radio-satellites/OS-41_PCB/README.md

# OS-41 PCB Tracker
