radio-satellites/OS-41_PCB/ANT_1575AT_JOT.step

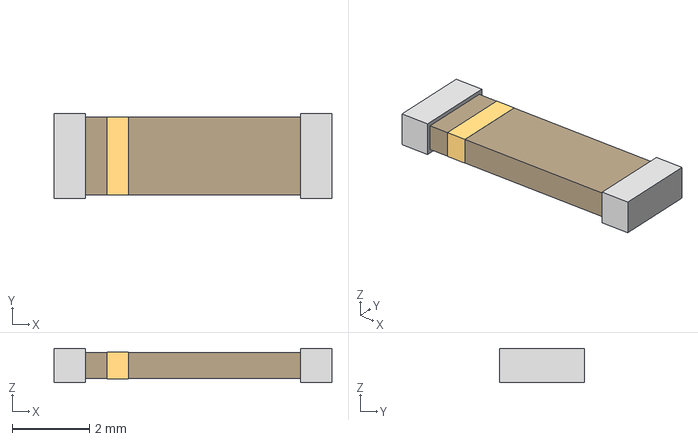
[picture p1: CAD file, 2025-06-10]
ANT_1575AT_JOT.step
7.19 x 2.21 x 0.889 mm
