radio-satellites/OS-41_PCB/Si4432.STEP

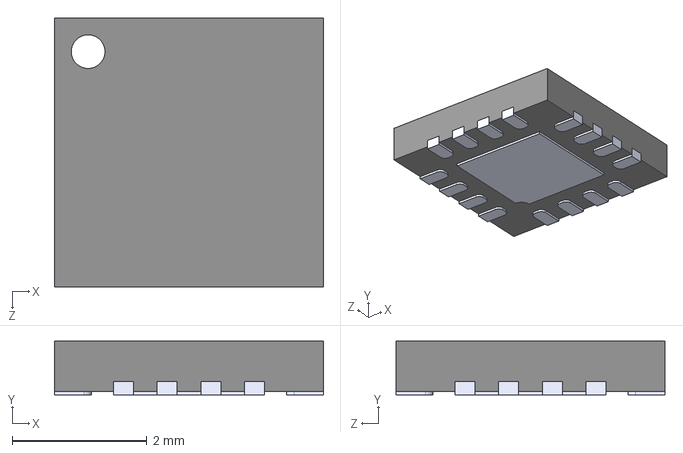
[picture p2: CAD file, 2025-05-10]
Si4432.STEP
4.00 x 0.8 x 4.00 mm
