radio-satellites/OS-41_PCB/STM32.STEP

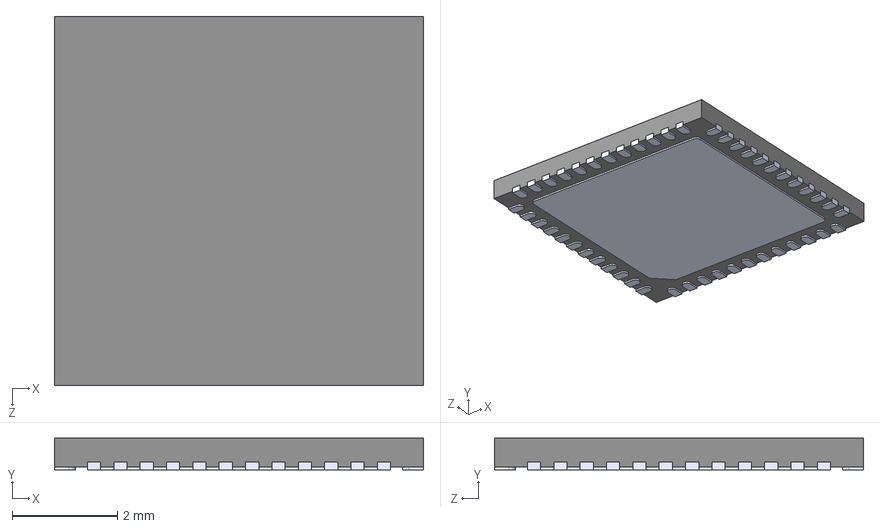
[picture p3: CAD file, 2025-05-10]
STM32.STEP
7.00 x 0.6 x 7.00 mm
