radio-satellites/OS-41_PCB/BMP390.STEP

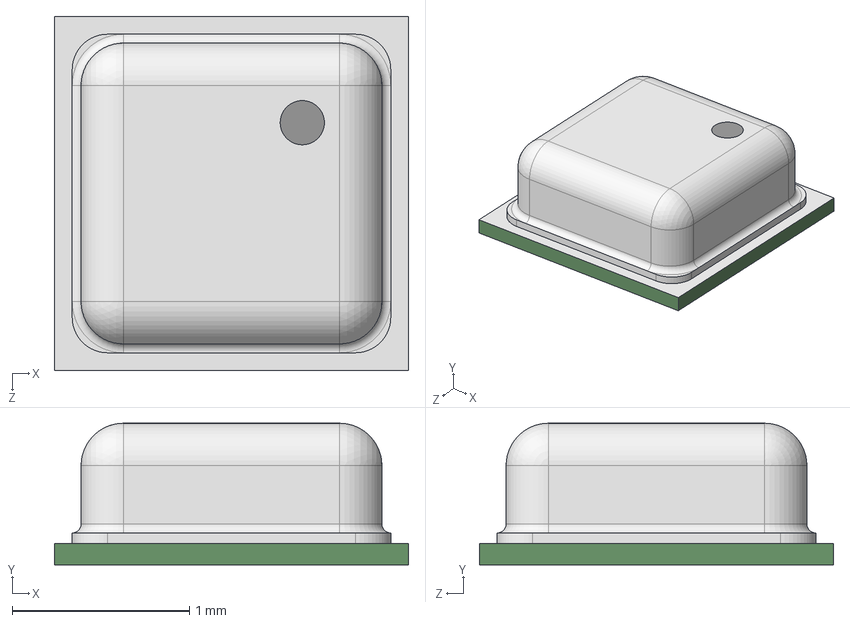
[picture p4: CAD file, 2025-05-10]
BMP390.STEP
2.00 x 0.8 x 2.00 mm
