radio-satellites/OS-41_PCB/SMA CONNECTOR--3DModel-STEP-1.STEP

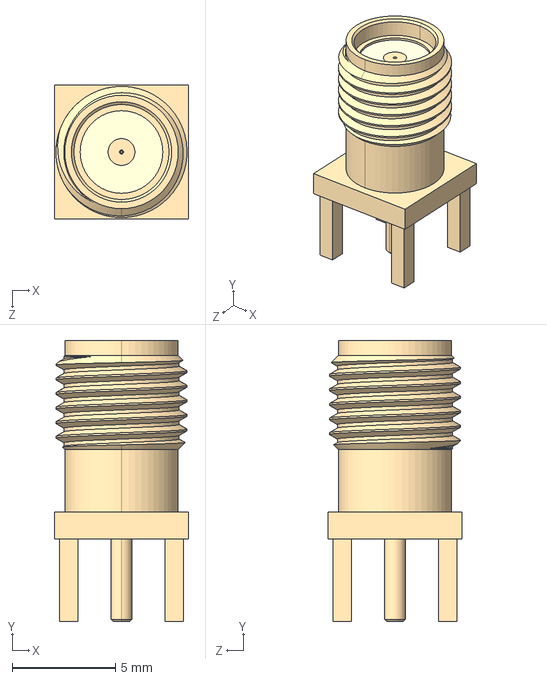
[picture p5: CAD file, 2025-05-10]
SMA CONNECTOR--3DModel-STEP-1.STEP
6.50 x 13.6 x 6.50 mm
