radio-satellites/OS-41_PCB/schematic.pdf/OS-41.pdf

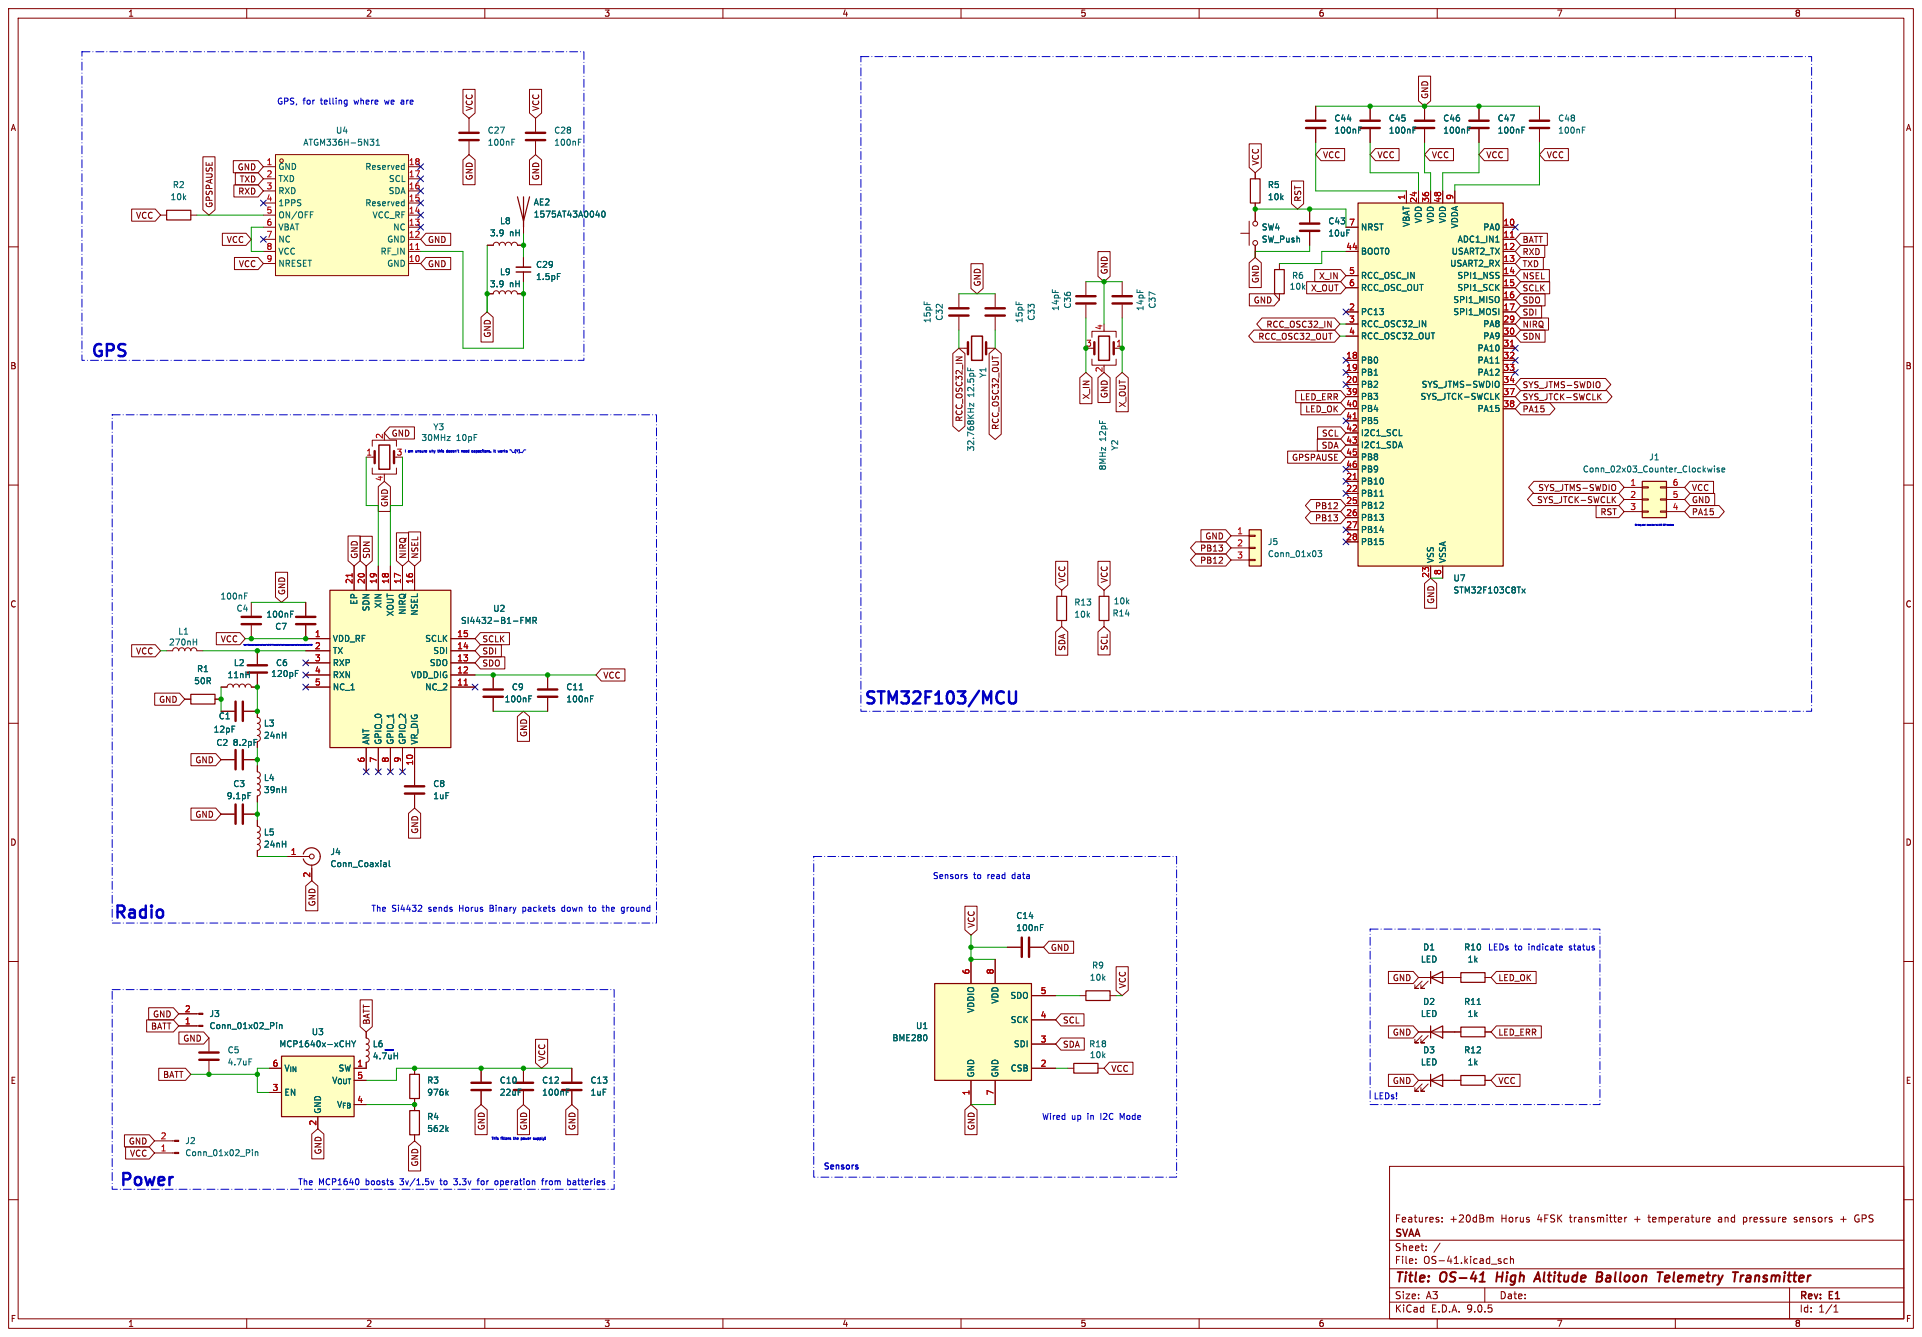
[picture p6: page 1]

Wired up in I2C Mode Power
