radio-satellites/OS-41_PCB/(commit log)

2024-11-18 Add PCB
    [BOM-OS-41.csv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]
2024-11-22 Add things
    [OS-41.csv, OS-41.kicad_pcb, OS-41.kicad_sch]
2024-11-22 Add temp. sensor lables
    [OS-41.kicad_pcb]
2024-11-25 Final PCB
    [BOM-OS-41.csv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]
2025-02-01 Major board revamp!
    [OS-41.kicad_pcb, OS-41.kicad_sch]
2025-02-02 Small changes
    [OS-41.kicad_pcb]
2025-02-02 rename to boot
    [OS-41.kicad_pcb]
2025-02-02 move PWR
    [OS-41.kicad_pcb]
2025-02-02 Clean up USB routing
    [OS-41.kicad_pcb]
2025-02-02 usb oops
    [OS-41.kicad_pcb]
2025-02-03 Adjust some silkscreen markings
    [OS-41.kicad_pcb]
2025-02-03 Reverse GPIO markings
    [OS-41.kicad_pcb]
2025-02-03 fixed decouple capacitor
    [OS-41.kicad_pcb]
2025-02-06 Move L6
    [OS-41.kicad_pcb]
2025-02-06 add polarity
    [OS-41.kicad_pcb]
2025-02-11 Fix some important things
    [OS-41.kicad_pcb, OS-41.kicad_sch]
2025-02-11 Rotate a capacitor
    [OS-41.kicad_pcb]
2025-02-11 Fix some silkscreen issues
    [OS-41.kicad_pcb]
2025-02-13 Add silkscreen graphics
    [OS-41.kicad_pcb]
2025-02-14 Place USB resistors closer to chip
    [OS-41.csv, OS-41.kicad_pcb]
2025-02-14 Fixed up some routing
    [OS-41.kicad_pcb]
2025-02-14 Add GPS ANT text
    [OS-41.kicad_pcb]
2025-02-15 Fix things
    [BOM-OS-41.csv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]
2025-02-16 Add comments to schematic
    [OS-41.kicad_sch]
2025-02-17 Fix minor footprint things
    [OS-41.kicad_pcb]
2025-02-21 Change designator to X2
    [OS-41.kicad_pcb, OS-41.kicad_sch]
2025-02-21 Move some capacitors
    [BOM-OS-41.csv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]
2025-02-21 Moved silkscreen text (oops)
    [OS-41.kicad_pcb]
2025-02-22 BMP390 oops (add pullup resistor for address selection)
    [OS-41.kicad_pcb, OS-41.kicad_sch]
2025-02-22 Move some silkscreen around
    [OS-41.kicad_pcb]
2025-02-22 Move R6 and R7
    [OS-41.kicad_pcb]
2025-02-24 Change I2C pullup values
    [OS-41.kicad_pcb, OS-41.kicad_sch]
2025-02-24 Fix some final DRC things
    [OS-41.kicad_pcb]
2025-02-24 Tried to reroute VBUS
    [OS-41.kicad_pcb]
2025-02-24 Move PWR text
    [OS-41.kicad_pcb]
2025-02-25 Resistor markings change
    [OS-41.kicad_pcb]
2025-02-25 Move a few decoupling capacitors away for the radio IC
    [OS-41.kicad_pcb]
2025-02-26 Final board
    [BOM-OS-41.csv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]
2025-03-31 Final RP2040 version (byeeeeeeee RP2040)
    [OS-41.kicad_pcb, OS-41.kicad_sch]
2025-04-05 Remove PCB board, start work on STM32F411
    [OS-41.kicad_pcb]
2025-04-17 Preliminary board
    [OS-41.kicad_pcb, OS-41.kicad_sch]
2025-05-10 Add 3d models
    [BMP390.STEP, OS-41.kicad_pcb, SMA CONNECTOR--3DModel-STEP-1.STEP, STM32.STEP, Si4432.STEP]
2025-05-10 Fix a few more things
    [OS-41.kicad_pcb]
2025-06-10 Change GPS antenna + routing fixes
    [ANT_1575AT_JOT.step, OS-41.kicad_pcb, OS-41.kicad_sch]
2025-07-27 Add GPS text
    [OS-41.kicad_pcb]
2025-11-12 Remaking the PCB... again...
    [OS-41-CuBottom.gbr, OS-41-CuIn1.gbr, OS-41-CuIn2.gbr, OS-41-CuTop.gbr, OS-41-EdgeCuts.gbr, OS-41-MaskBottom.gbr, OS-41-MaskTop.gbr, OS-41-NPTH.drl]
2025-11-13 Continue layout
    [OS-41.kicad_pcb, OS-41.kicad_sch]
2025-11-14 More layout, no routing yet...
    [OS-41.kicad_pcb, OS-41.kicad_sch]
2025-11-15 Finished V1 layout!
    [OS-41.kicad_pcb]
2025-11-15 Layout initial done
    [OS-41.kicad_pcb]
2025-11-16 Start routing!
    [OS-41.kicad_pcb, OS-41.kicad_sch]
2025-11-16 Continue routing
    [OS-41.kicad_pcb, OS-41.kicad_sch]
2025-11-16 Routed first version!
    [OS-41.kicad_pcb, OS-41.kicad_sch]
2025-11-16 More routing!
    [OS-41.kicad_pcb, OS-41.kicad_sch]
2025-11-16 RF trace reroute
    [OS-41.kicad_pcb]
2025-11-16 Link more 3d models
    [OS-41.kicad_pcb]
2025-11-18 More routing...
    [OS-41.kicad_pcb]
2025-11-18 Add GPIO breakouts
    [OS-41.kicad_pcb, OS-41.kicad_sch, bom.csv, designators.csv, positions.csv]
2025-11-19 oops...push via
    [OS-41.kicad_pcb]
2025-11-22 Fix up DRC
    [OS-41.kicad_pcb]
2025-11-22 Add final DRC things
    [OS-41.kicad_pcb, OS-41.kicad_sch, bom.csv, designators.csv, positions.csv]
2025-11-30 FINALLY found the button footprint...
    [OS-41.csv, OS-41.kicad_pcb, OS-41.kicad_sch]
2025-12-01 add notice
    [OS-41.kicad_sch]
